SchmidtJu/SoundMixer/docs/4ab533d5-0cb5-4ea4-8205-7bcd813ed71a.jpg

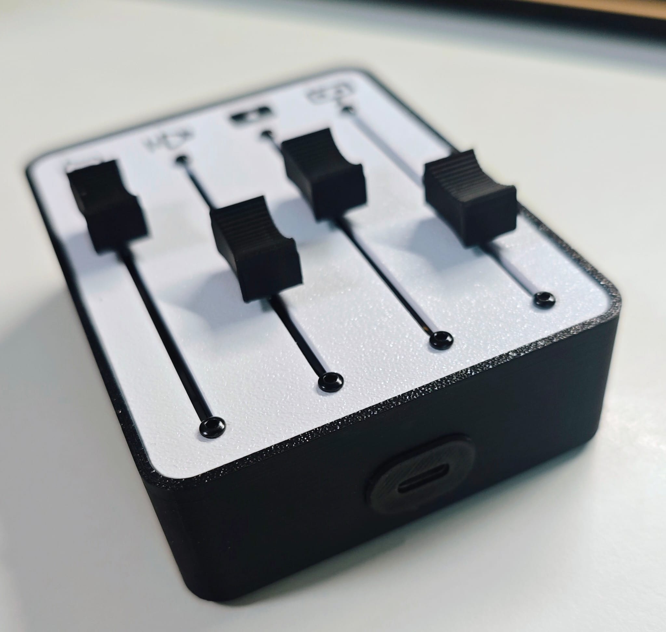
docs/4ab533d5-0cb5-4ea4-8205-7bcd813ed71a.jpg
