SchmidtJu/SoundMixer/model/SoundMixer.3mf

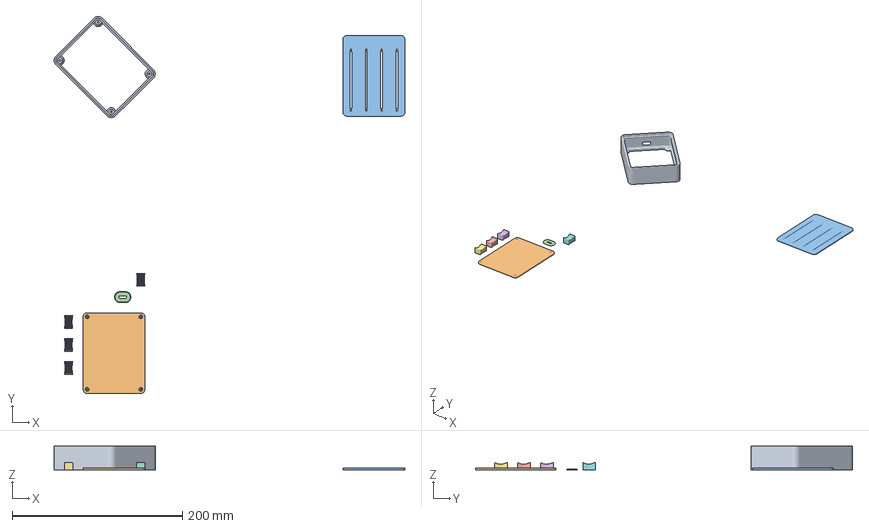
[picture p3: CAD file, 2026-10-21]
model/SoundMixer.3mf
411.7 x 442.3 x 28.0 mm
gehäuse
unten deckel
SoundMixer v6
Körper47
Knopf x 4
