SchmidtJu/SoundMixer/model/stl/usb lid.stl

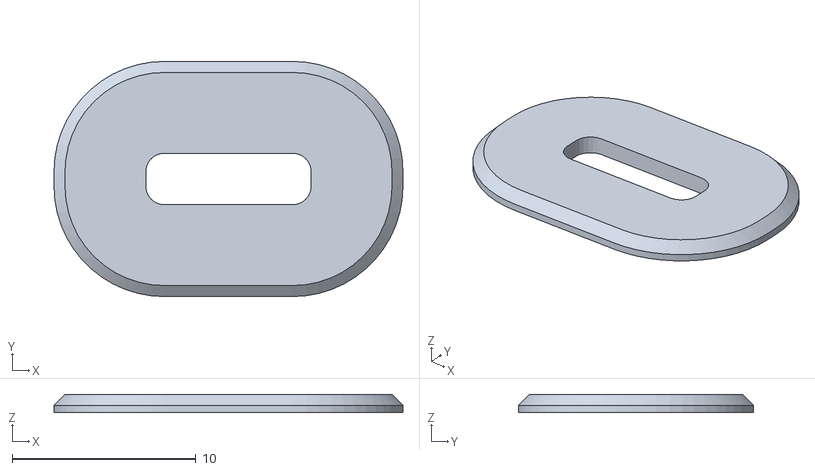
[picture p4: CAD file, 2026-10-21]
model/stl/usb lid.stl
19.0 x 12.8 x 1.00
