SchmidtJu/SoundMixer/model/Deckel.3mf

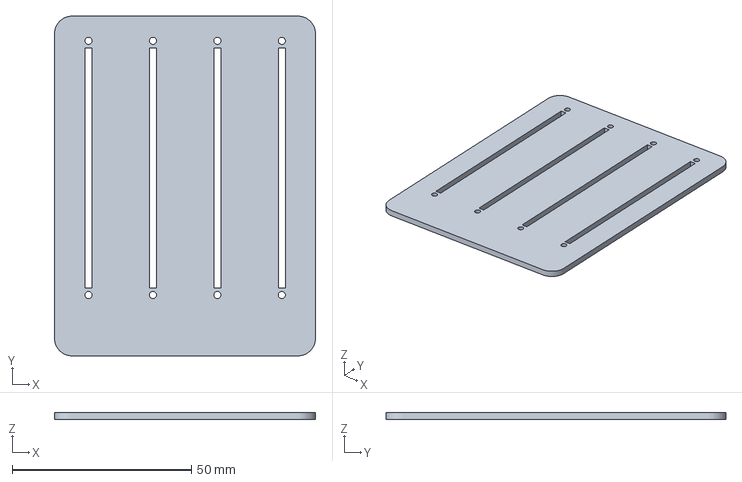
[picture p5: CAD file, 2026-10-21]
model/Deckel.3mf
72.9 x 94.9 x 2.00 mm
