SchmidtJu/SoundMixer/(list of files, cad)

Other CAD files:
model/stl/Top.stl
